Preston-Yu/G-CU/PCB Design/v1.0/PCB_PCB1_2023-10-24.pdf

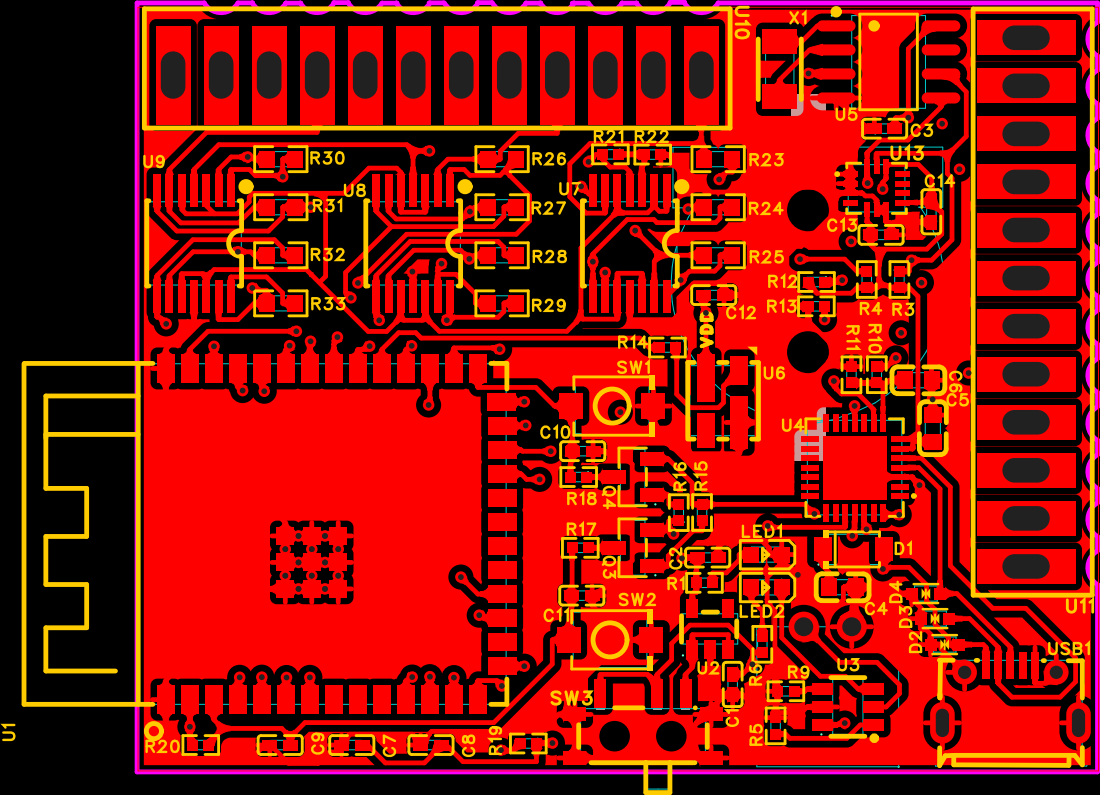
[picture p2: page 1]

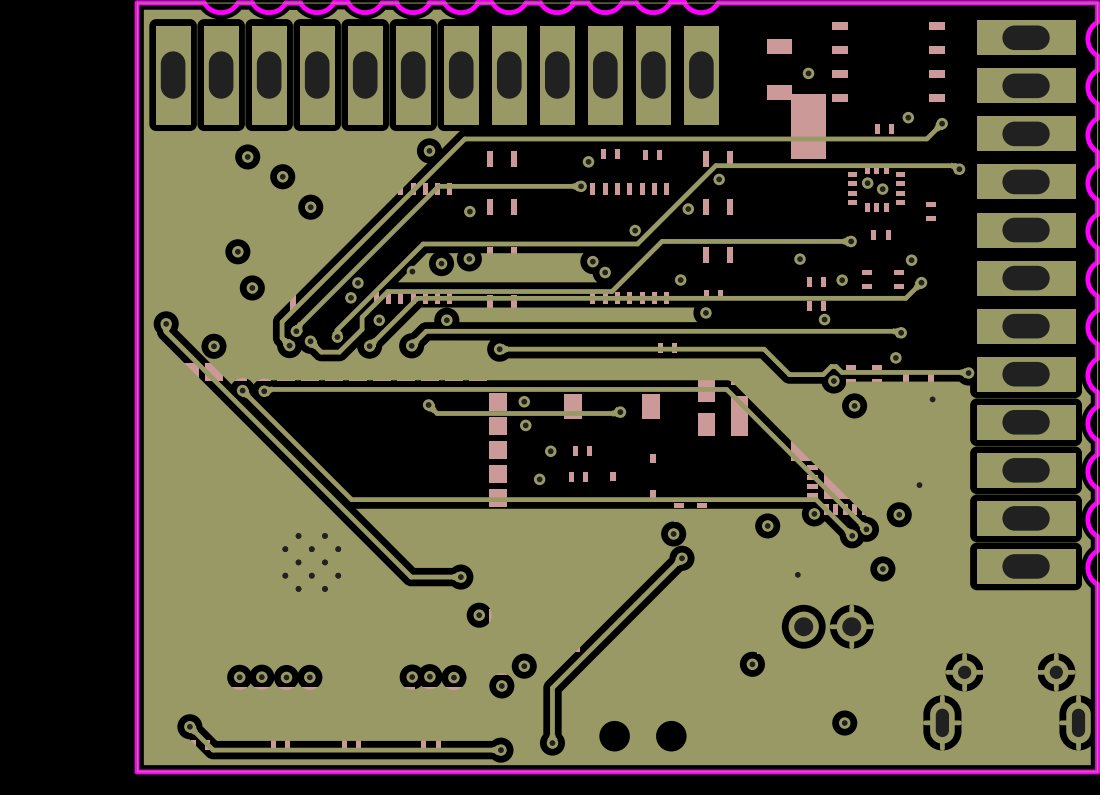
[picture p3: page 2]

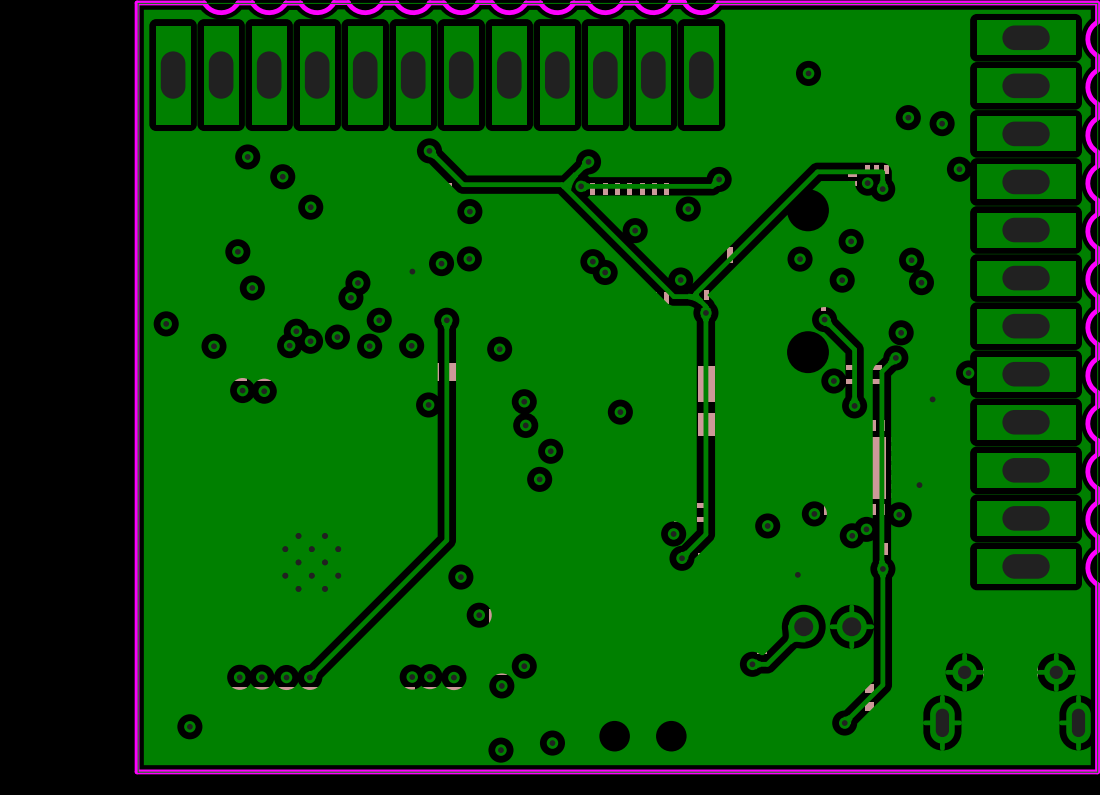
[picture p4: page 3]

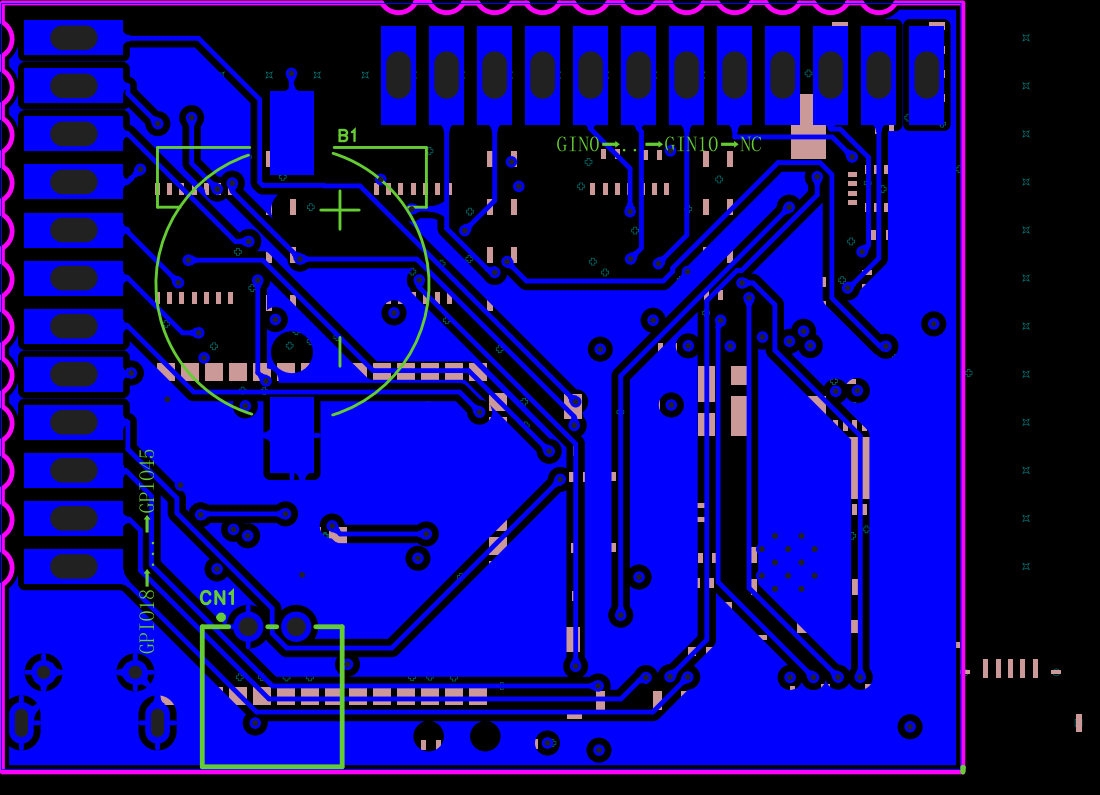
[picture p5: page 4]
