Preston-Yu/G-CU/PCB Design/v0.0/PCB_PCB1_2023-07-19.pdf

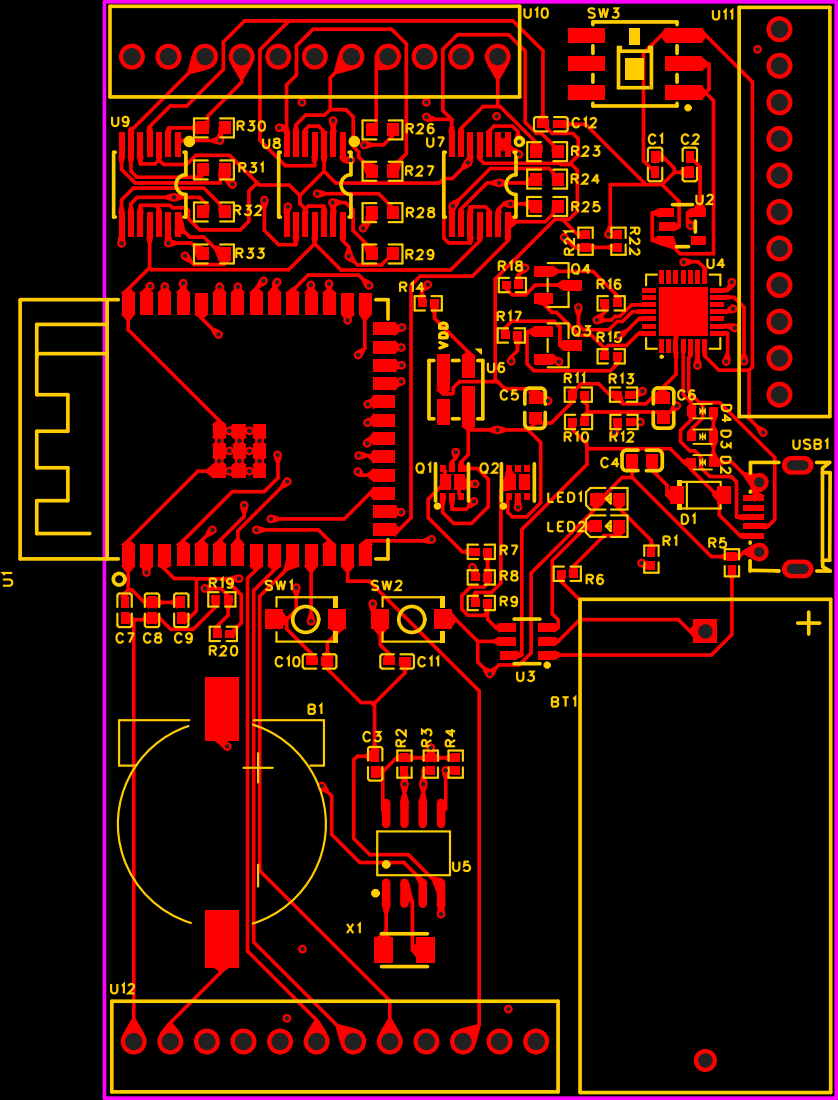
[picture p6: page 1]

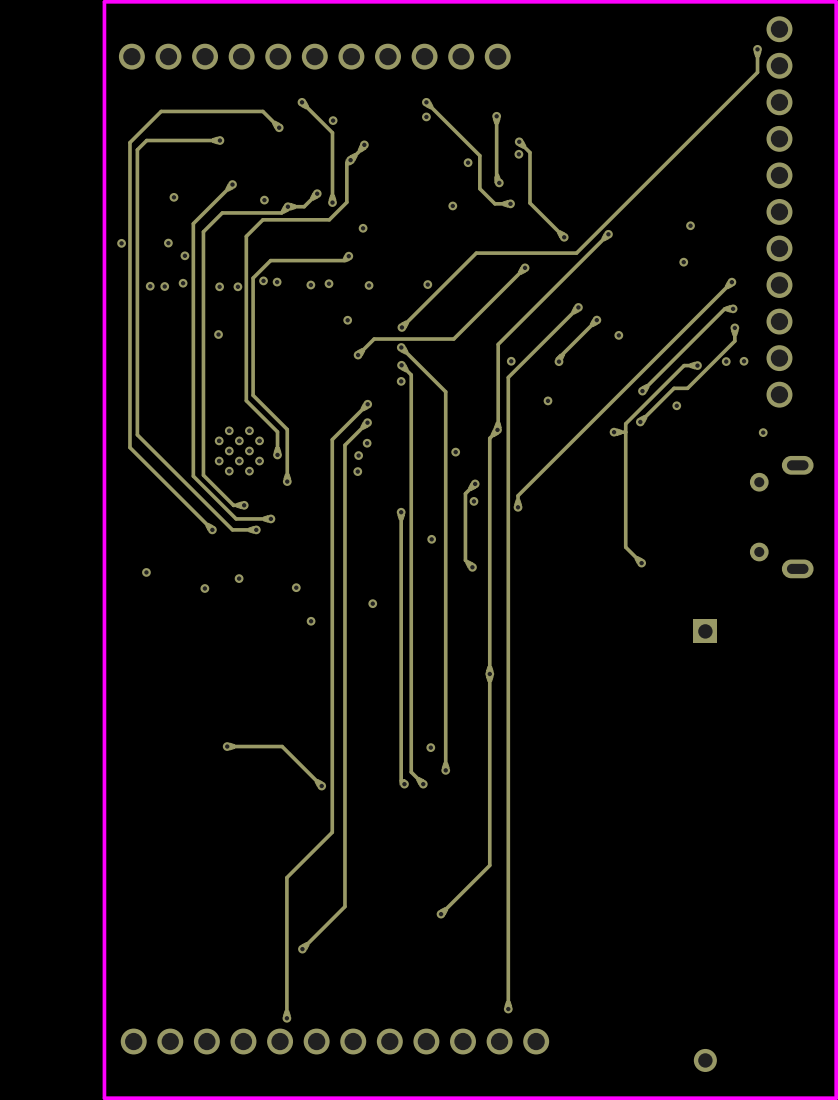
[picture p7: page 2]

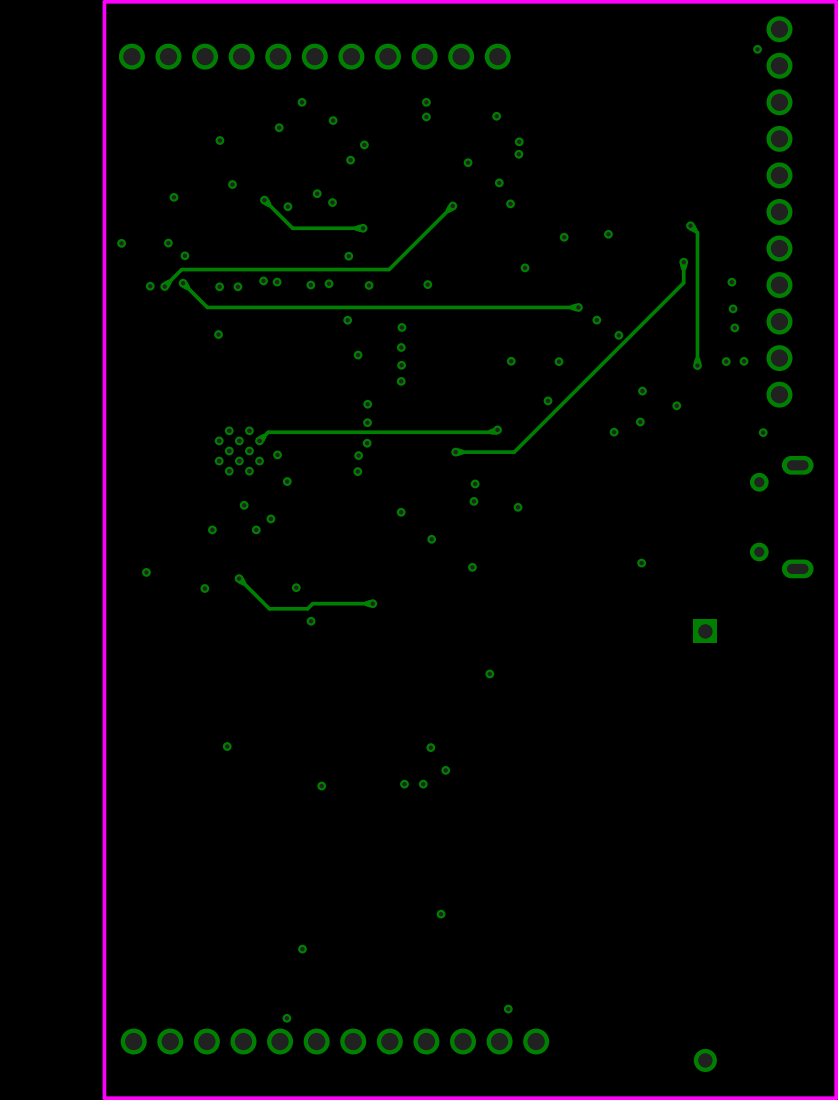
[picture p8: page 3]

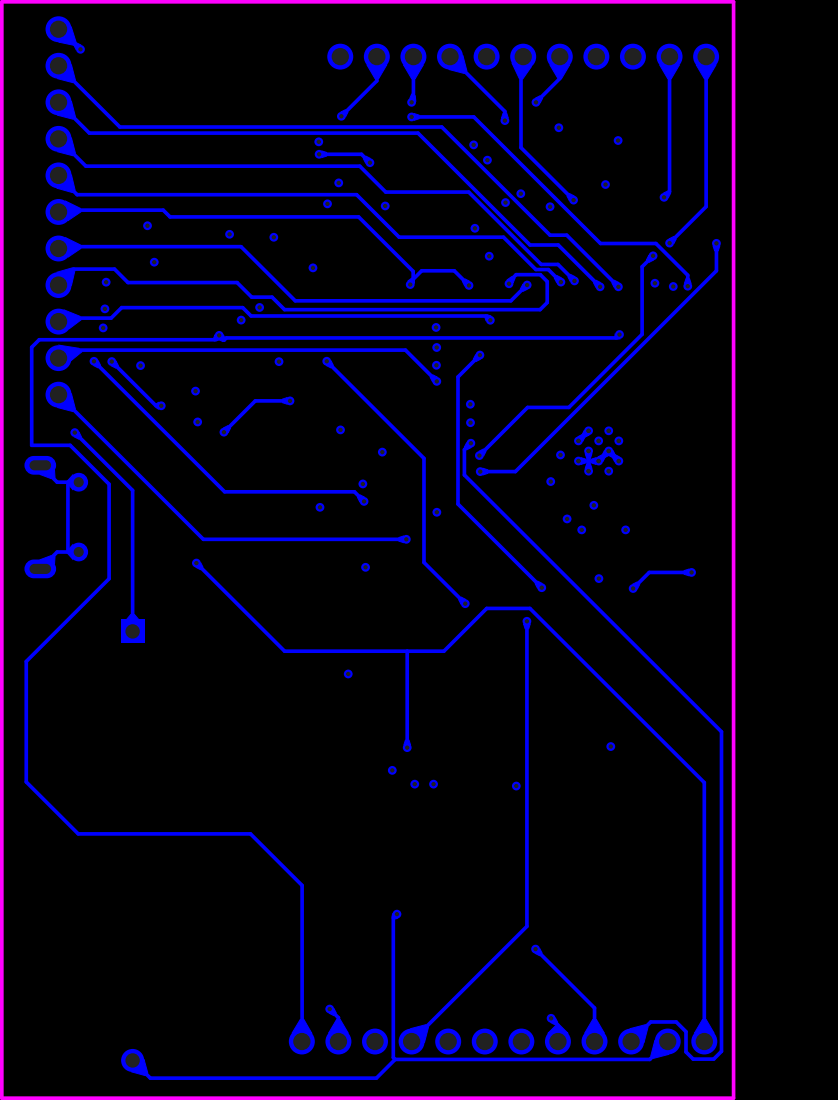
[picture p9: page 4]
