Preston-Yu/G-CU/PCB Design/v0.0/PCB_PCB1_2023-07-19_Mix.pdf

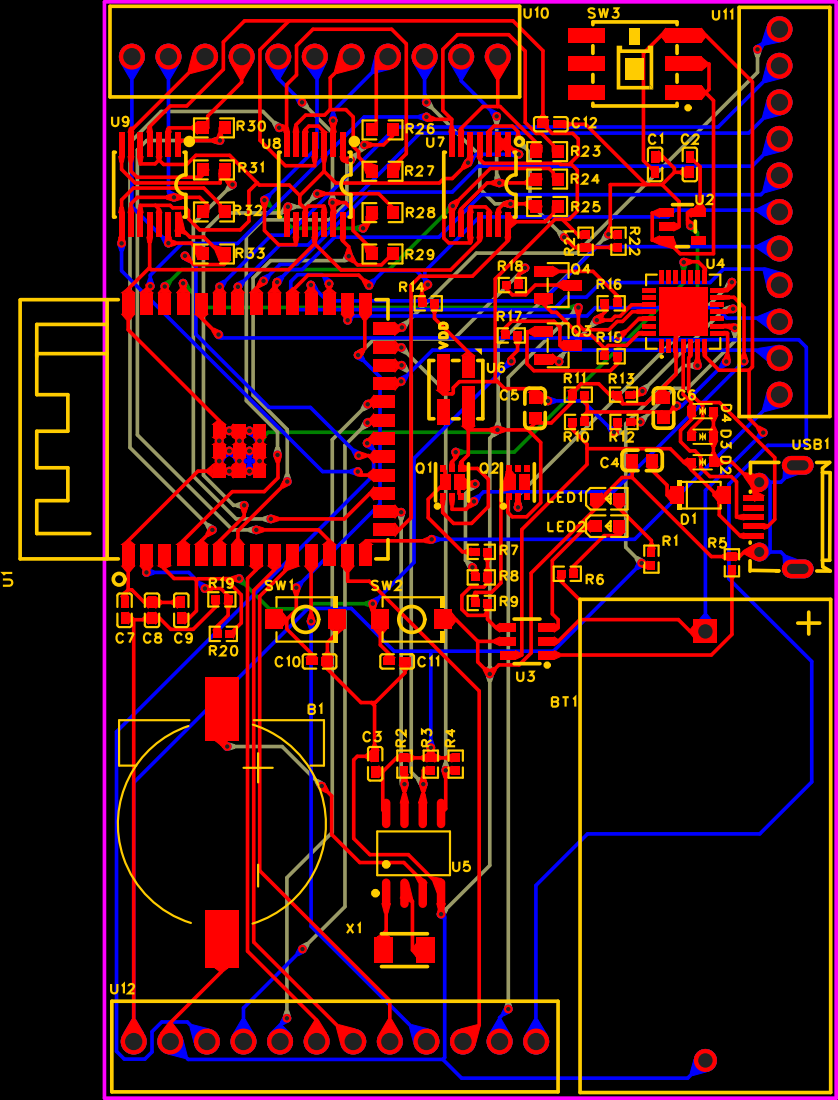
[picture p10: page 1]

R24 | U2
R25
