Preston-Yu/G-CU/(list of files, drawings)

Other design files:
PCB Design/Project/Connector_FPC_V2025.12.eprj
PCB Design/Project/G-CU ver 2.0.B.eprj
PCB Design/Project/G-CU ver 2.3.C.eprj
PCB Design/Project/G-CU.eprj
PCB Design/Project/G-CU_2023-06-21_21-38-10.eprj
PCB Design/Project/G-CU_2023-09-08_13-42-00.eprj
